raphaelabrams/freelance-puncher/(commit log)

2011-09-26 first commit, just eagle files.
    [puncher.brd, puncher.sch]
2011-10-18 tightened things up, made the board millable with a .01" bit.
    [puncher.brd, puncher.sch]
2011-10-20 keeping up
    [puncher.brd, puncher.sch]
2011-10-21 got timer and display mostly working
2011-10-22 numbers mapped, save and recover ffrom power off seem to work
2011-10-23 Finished! Fixed somedisplay issues, stopped incrementing the seconds value too many times, cleaned up the display during startup, moved the reset routine to the interrupt section.
    Also added the hex file and some milling files for your convenience.
    [puncher.c]
2011-10-24 bug fix with quarter-hour display
    [puncher.c]
2012-03-06 added pdf file containing the outlines for laser cutting 1/8" acrylic to create a project enclosure. I recommend some kind of tinted or smoked clear acrylic. galaxyplastic.com has some great stuff.
2012-03-29 added circuit boasrd link to sparkfun
